kdp1965/ihp-um-janestreet-prism/Calvin.png

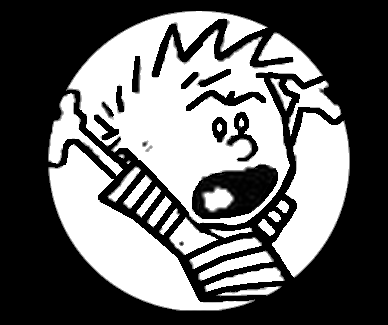
Calvin.png
