kdp1965/ihp-um-janestreet-prism/docs/user_peripherals/08_comm_register.png

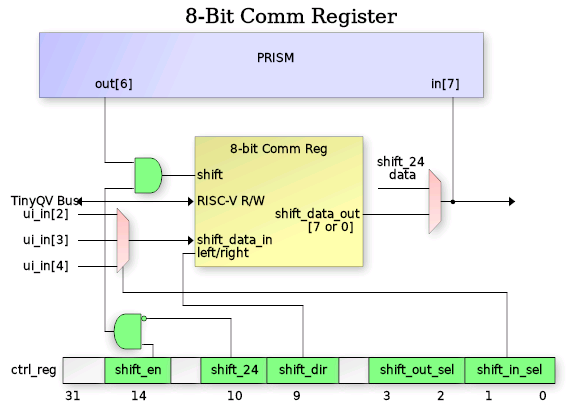
docs/user_peripherals/08_comm_register.png
