kdp1965/ihp-um-janestreet-prism/macros/CALVIN_UP/preview.png

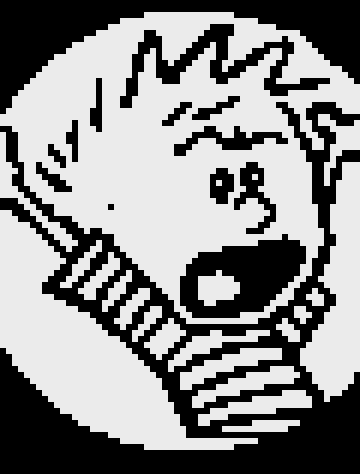
macros/CALVIN_UP/preview.png
