kdp1965/ihp-um-janestreet-prism/site/JaneStreet_PRISM_PDN.png

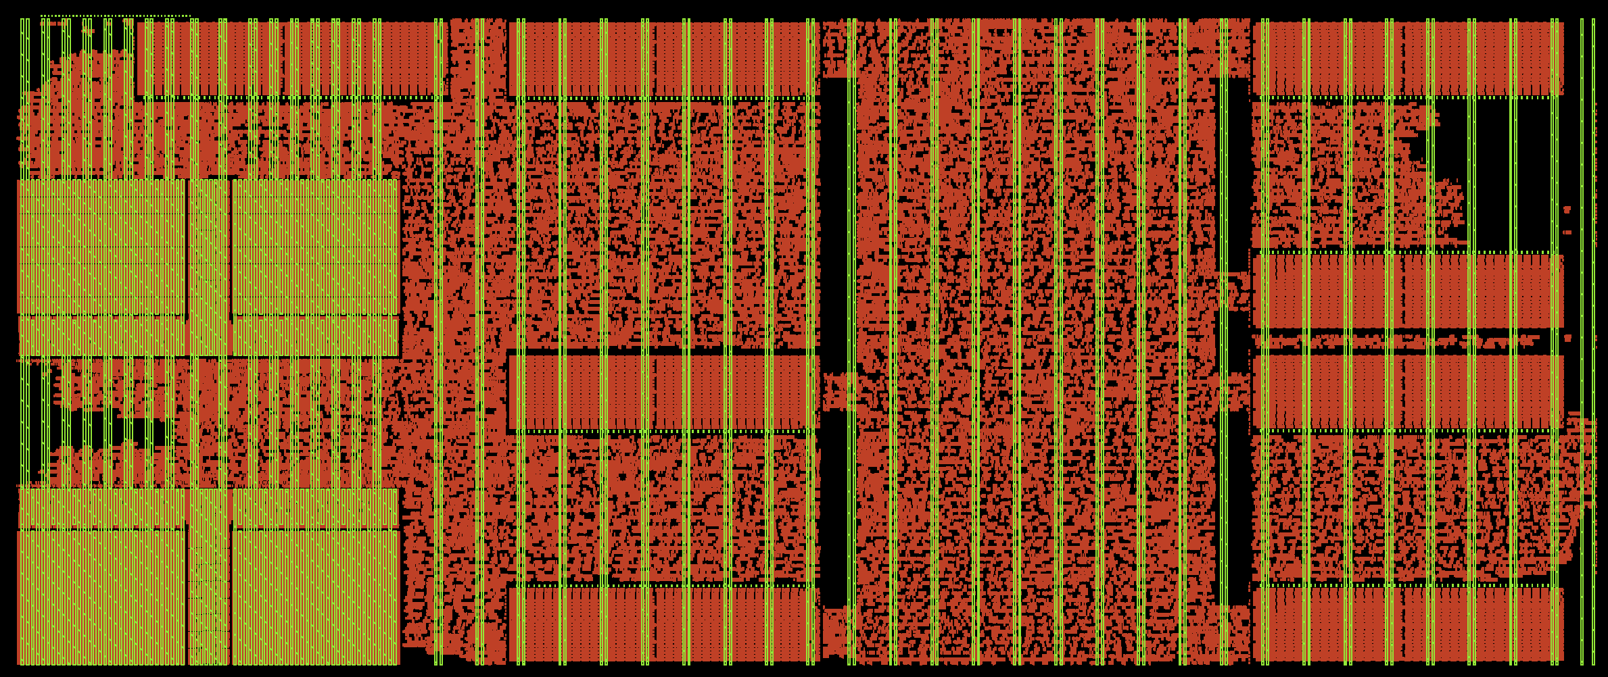
site/JaneStreet_PRISM_PDN.png
