kdp1965/ihp-um-janestreet-prism/local_build/metrics.csv

Metric | Value
design__lint_error__count | 0
design__lint_timing_construct__count | 0
design__lint_warning__count | 37
design__inferred_latch__count | 0
design__instance__count | 72371
design__instance__area | 1184660
design__instance_unmapped__count | 0
synthesis__check_error__count | 0
design__max_slew_violation__count__corner:nom_fast_1p32V_m40C | 644
design__max_fanout_violation__count__corner:nom_fast_1p32V_m40C | 520
design__max_cap_violation__count__corner:nom_fast_1p32V_m40C | 45
power__internal__total | 0.011855394579470158
power__switching__total | 0.0037356307730078697
power__leakage__total | 2.741479329415597e-05
power__total | 0.015618439763784409
clock__skew__worst_hold__corner:nom_fast_1p32V_m40C | -0.438640053361761
clock__skew__worst_setup__corner:nom_fast_1p32V_m40C | 0.4999133470904773
timing__hold__ws__corner:nom_fast_1p32V_m40C | 0.0594799781818965
timing__setup__ws__corner:nom_fast_1p32V_m40C | 1.0040129012360002
timing__hold__tns__corner:nom_fast_1p32V_m40C | 0
timing__setup__tns__corner:nom_fast_1p32V_m40C | 0
timing__hold__wns__corner:nom_fast_1p32V_m40C | 0
timing__setup__wns__corner:nom_fast_1p32V_m40C | 0
timing__hold_vio__count__corner:nom_fast_1p32V_m40C | 0
timing__hold_r2r__ws__corner:nom_fast_1p32V_m40C | 0.05948
timing__hold_r2r_vio__count__corner:nom_fast_1p32V_m40C | 0
timing__setup_vio__count__corner:nom_fast_1p32V_m40C | 0
timing__setup_r2r__ws__corner:nom_fast_1p32V_m40C | 1.84766
timing__setup_r2r_vio__count__corner:nom_fast_1p32V_m40C | 0
design__max_slew_violation__count__corner:nom_slow_1p08V_125C | 6237
design__max_fanout_violation__count__corner:nom_slow_1p08V_125C | 520
design__max_cap_violation__count__corner:nom_slow_1p08V_125C | 44
clock__skew__worst_hold__corner:nom_slow_1p08V_125C | -0.5062046480820508
clock__skew__worst_setup__corner:nom_slow_1p08V_125C | 0.609072476360298
timing__hold__ws__corner:nom_slow_1p08V_125C | 0.49745409199907764
timing__setup__ws__corner:nom_slow_1p08V_125C | -7.69049112826307
timing__hold__tns__corner:nom_slow_1p08V_125C | 0
timing__setup__tns__corner:nom_slow_1p08V_125C | -3421.3570474017506
timing__hold__wns__corner:nom_slow_1p08V_125C | 0
timing__setup__wns__corner:nom_slow_1p08V_125C | -7.69049112826307
timing__hold_vio__count__corner:nom_slow_1p08V_125C | 0
timing__hold_r2r__ws__corner:nom_slow_1p08V_125C | 0.497454
timing__hold_r2r_vio__count__corner:nom_slow_1p08V_125C | 0
timing__setup_vio__count__corner:nom_slow_1p08V_125C | 867
timing__setup_r2r__ws__corner:nom_slow_1p08V_125C | -7.690491
timing__setup_r2r_vio__count__corner:nom_slow_1p08V_125C | 862
design__max_slew_violation__count__corner:nom_typ_1p20V_25C | 2100
design__max_fanout_violation__count__corner:nom_typ_1p20V_25C | 520
design__max_cap_violation__count__corner:nom_typ_1p20V_25C | 45
clock__skew__worst_hold__corner:nom_typ_1p20V_25C | -0.46138624782243626
clock__skew__worst_setup__corner:nom_typ_1p20V_25C | 0.5416784951681427
timing__hold__ws__corner:nom_typ_1p20V_25C | 0.2227272873620312
timing__setup__ws__corner:nom_typ_1p20V_25C | 0.36041126658798145
timing__hold__tns__corner:nom_typ_1p20V_25C | 0
timing__setup__tns__corner:nom_typ_1p20V_25C | 0
timing__hold__wns__corner:nom_typ_1p20V_25C | 0
timing__setup__wns__corner:nom_typ_1p20V_25C | 0
timing__hold_vio__count__corner:nom_typ_1p20V_25C | 0
timing__hold_r2r__ws__corner:nom_typ_1p20V_25C | 0.222727
timing__hold_r2r_vio__count__corner:nom_typ_1p20V_25C | 0
timing__setup_vio__count__corner:nom_typ_1p20V_25C | 0
timing__setup_r2r__ws__corner:nom_typ_1p20V_25C | 0.360411
timing__setup_r2r_vio__count__corner:nom_typ_1p20V_25C | 0
design__max_slew_violation__count | 6237
design__max_fanout_violation__count | 520
design__max_cap_violation__count | 45
clock__skew__worst_hold | -0.438640053361761
clock__skew__worst_setup | 0.4999133470904773
timing__hold__ws | 0.0594799781818965
timing__setup__ws | -7.69049112826307
timing__hold__tns | 0
timing__setup__tns | -3421.3570474017506
timing__hold__wns | 0
timing__setup__wns | -7.69049112826307
timing__hold_vio__count | 0
timing__hold_r2r__ws | 0.05948
timing__hold_r2r_vio__count | 0
timing__setup_vio__count | 867
timing__setup_r2r__ws | -7.690491
timing__setup_r2r_vio__count | 862
design__die__bbox | 0.0 0.0 1724.16 710.64
design__core__bbox | 2.88 3.78 1721.28 706.86
design__io | 45
design__die__area | 1225260
design__core__area | 1208170
design__instance__count__stdcell | 31305
design__instance__area__stdcell | 448407
design__instance__count__macros | 10
design__instance__area__macros | 396139
design__instance__count__padcells | 0
design__instance__area__padcells | 0
design__instance__count__cover | 0
design__instance__area__cover | 0
design__instance__utilization | 0.699028
design__instance__utilization__stdcell | 0.552203
design__rows | 395
design__rows:CoreSite | 395
design__sites | 434589
design__sites:CoreSite | 434589
design__instance__count__class:macro | 10
design__instance__area__class:macro | 396139
design__instance__count__class:buffer | 42
design__instance__area__class:buffer | 304.819
design__instance__count__class:inverter | 956
design__instance__area__class:inverter | 5363.37
design__instance__count__class:sequential_cell | 3537
design__instance__area__class:sequential_cell | 154498
design__instance__count__class:multi_input_combinational_cell | 19081
design__instance__area__class:multi_input_combinational_cell | 195518
flow__warnings__count | 1
flow__errors__count | 0
flow__warnings__count:ODB-0220 | 3
flow__warnings__count:STA-1140 | 3
flow__warnings__type_count | 1
flow__warnings__count:ORD-0039 | 1
flow__warnings__count:PSM-0038 | 1001
flow__warnings__count:PSM-0039 | 20
design__power_grid_violation__count__net:VGND | 389512
design__power_grid_violation__count__net:VPWR | 394286
design__power_grid_violation__count | 783798
flow__warnings__count:GRT-0281 | 2
timing__drv__floating__nets | 0
timing__drv__floating__pins | 0
design__instance__displacement__total | 6824.7
design__instance__displacement__mean | 0.218
design__instance__displacement__max | 60.48
route__wirelength__estimated | 1960800
design__violations | 0
design__instance__count__class:timing_repair_buffer | 6808
design__instance__area__class:timing_repair_buffer | 82524.4
design__instance__count__class:clock_buffer | 284
design__instance__area__class:clock_buffer | 6649.78
design__instance__count__class:clock_inverter | 109
design__instance__area__class:clock_inverter | 968.89
design__instance__count__setup_buffer | 201
design__instance__count__hold_buffer | 0
flow__warnings__count:RSZ-0062 | 1
design__instance__count__class:antenna_cell | 530
design__instance__area__class:antenna_cell | 2884.9
global_route__vias | 135
global_route__wirelength | 3910600
flow__warnings__count:GRT-0115 | 2
flow__warnings__count:GRT-0273 | 15
antenna__violating__nets | 0
antenna__violating__pins | 0
route__antenna_violation__count | 0
antenna_diodes_count | 52
flow__warnings__count:EST-0026 | 1001
route__net | 30971
route__net__special | 2
route__drc_errors__iter:0 | 461
route__wirelength__iter:0 | 2585678
route__drc_errors__iter:1 | 199
route__wirelength__iter:1 | 2585577
route__drc_errors__iter:2 | 152
route__wirelength__iter:2 | 2585538
route__drc_errors__iter:3 | 61
route__wirelength__iter:3 | 2585558
route__drc_errors__iter:4 | 5
route__wirelength__iter:4 | 2585567
route__drc_errors__iter:5 | 0
route__wirelength__iter:5 | 2585567
route__drc_errors__iter:6 | 82
route__wirelength__iter:6 | 2583481
route__drc_errors__iter:7 | 79
route__wirelength__iter:7 | 2583433
route__drc_errors__iter:8 | 72
route__wirelength__iter:8 | 2583430
route__drc_errors__iter:9 | 72
route__wirelength__iter:9 | 2583430
route__drc_errors__iter:10 | 32
route__wirelength__iter:10 | 2583499
route__drc_errors__iter:11 | 29
route__wirelength__iter:11 | 2583499
route__drc_errors__iter:12 | 29
route__wirelength__iter:12 | 2583499
route__drc_errors__iter:13 | 4
route__wirelength__iter:13 | 2583547
route__drc_errors__iter:14 | 4
route__wirelength__iter:14 | 2583547
route__drc_errors__iter:15 | 4
route__wirelength__iter:15 | 2583547
route__drc_errors__iter:16 | 3
route__wirelength__iter:16 | 2583548
route__drc_errors__iter:17 | 3
route__wirelength__iter:17 | 2583548
route__drc_errors__iter:18 | 3
route__wirelength__iter:18 | 2583548
route__drc_errors__iter:19 | 0
route__wirelength__iter:19 | 2583550
route__drc_errors__iter:20 | 28
route__wirelength__iter:20 | 2587248
route__drc_errors__iter:21 | 10
route__wirelength__iter:21 | 2587279
route__drc_errors__iter:22 | 9
route__wirelength__iter:22 | 2587278
route__drc_errors__iter:23 | 7
route__wirelength__iter:23 | 2587277
route__drc_errors__iter:24 | 7
route__wirelength__iter:24 | 2587277
route__drc_errors__iter:25 | 7
route__wirelength__iter:25 | 2587277
route__drc_errors__iter:26 | 7
route__wirelength__iter:26 | 2587277
route__drc_errors__iter:27 | 5
route__wirelength__iter:27 | 2587276
route__drc_errors__iter:28 | 5
route__wirelength__iter:28 | 2587275
route__drc_errors__iter:29 | 5
route__wirelength__iter:29 | 2587277
route__drc_errors__iter:30 | 5
route__wirelength__iter:30 | 2587278
route__drc_errors__iter:31 | 5
route__wirelength__iter:31 | 2587279
route__drc_errors__iter:32 | 4
route__wirelength__iter:32 | 2587287
route__drc_errors__iter:33 | 4
route__wirelength__iter:33 | 2587287
route__drc_errors__iter:34 | 4
route__wirelength__iter:34 | 2587288
route__drc_errors__iter:35 | 4
route__wirelength__iter:35 | 2587286
route__drc_errors__iter:37 | 4
route__wirelength__iter:37 | 2587286
route__drc_errors__iter:38 | 4
route__wirelength__iter:38 | 2587287
route__drc_errors__iter:39 | 4
route__wirelength__iter:39 | 2587287
route__drc_errors__iter:40 | 4
route__wirelength__iter:40 | 2587287
route__drc_errors__iter:41 | 4
route__wirelength__iter:41 | 2587287
route__drc_errors__iter:42 | 4
route__wirelength__iter:42 | 2587287
route__drc_errors__iter:43 | 3
route__wirelength__iter:43 | 2587393
route__drc_errors__iter:44 | 3
route__wirelength__iter:44 | 2587393
route__drc_errors__iter:45 | 3
route__wirelength__iter:45 | 2587382
route__drc_errors__iter:46 | 3
route__wirelength__iter:46 | 2587379
route__drc_errors__iter:49 | 3
route__wirelength__iter:49 | 2587379
route__drc_errors__iter:50 | 3
route__wirelength__iter:50 | 2587379
route__drc_errors__iter:51 | 3
route__wirelength__iter:51 | 2587379
route__drc_errors__iter:52 | 3
route__wirelength__iter:52 | 2587379
route__drc_errors__iter:53 | 2
route__wirelength__iter:53 | 2587497
route__drc_errors__iter:54 | 2
route__wirelength__iter:54 | 2587497
route__drc_errors__iter:55 | 2
route__wirelength__iter:55 | 2587515
route__drc_errors__iter:57 | 2
route__wirelength__iter:57 | 2587515
route__drc_errors__iter:58 | 2
route__wirelength__iter:58 | 2587515
route__drc_errors__iter:59 | 2
route__wirelength__iter:59 | 2587515
route__drc_errors__iter:60 | 0
route__wirelength__iter:60 | 2587598
route__drc_errors | 0
route__wirelength | 2585567
route__vias | 292989
route__vias__singlecut | 292989
route__vias__multicut | 0
flow__warnings__count:DRT-0349 | 7
design__disconnected_pin__count | 5
design__critical_disconnected_pin__count | 0
route__wirelength__max | 3079.05
design__instance__count__class:fill_cell | 41056
design__instance__area__class:fill_cell | 340111
timing__unannotated_net__count__corner:nom_fast_1p32V_m40C | 163
timing__unannotated_net_filtered__count__corner:nom_fast_1p32V_m40C | 0
timing__unannotated_net__count__corner:nom_slow_1p08V_125C | 163
timing__unannotated_net_filtered__count__corner:nom_slow_1p08V_125C | 0
timing__unannotated_net__count__corner:nom_typ_1p20V_25C | 163
timing__unannotated_net_filtered__count__corner:nom_typ_1p20V_25C | 0
timing__unannotated_net__count | 163
timing__unannotated_net_filtered__count | 0
design_powergrid__voltage__worst__net:VPWR__corner:nom_slow_1p08V_125C | 1.19956
design_powergrid__drop__average__net:VPWR__corner:nom_slow_1p08V_125C | 1.19995
design_powergrid__drop__worst__net:VPWR__corner:nom_slow_1p08V_125C | 0.000437035
design_powergrid__voltage__worst__net:VGND__corner:nom_slow_1p08V_125C | 0.000285402
design_powergrid__drop__average__net:VGND__corner:nom_slow_1p08V_125C | 4.48055e-05
design_powergrid__drop__worst__net:VGND__corner:nom_slow_1p08V_125C | 0.000285402
flow__warnings__count:STA-1648 | 292
flow__warnings__count:STA-1650 | 1001
design_powergrid__voltage__worst | 0.000285402
design_powergrid__voltage__worst__net:VPWR | 1.19956
design_powergrid__drop__worst | 0.000437035
design_powergrid__drop__worst__net:VPWR | 0.000437035
design_powergrid__voltage__worst__net:VGND | 0.000285402
design_powergrid__drop__worst__net:VGND | 0.000285402
ir__voltage__worst | 1.2
ir__drop__avg | 4.67e-05
ir__drop__worst | 0.000437
klayout__drc_error__count | 0
magic__illegal_overlap__count | 96
design__lvs_device_difference__count | 0
design__lvs_net_difference__count | 0
design__lvs_property_fail__count | 0
design__lvs_error__count | 0
design__lvs_unmatched_device__count | 0
design__lvs_unmatched_net__count | 0
design__lvs_unmatched_pin__count | 0
