kdp1965/ihp-um-janestreet-prism/local_build/render/tt_um_pettit_js_prism.png

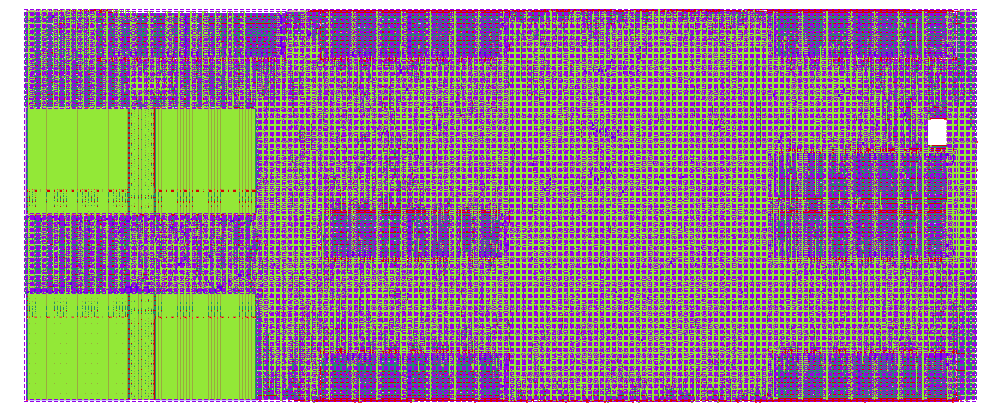
local_build/render/tt_um_pettit_js_prism.png
