kdp1965/ihp-um-janestreet-prism/chromas/output/chroma_encoder.c

/*
==============================================================
PRISM Downloadable Configuration

Input:    chroma_encoder.sv
Config:   tinyqv32.cfg
==============================================================
*/

#include <stdint.h>

const uint32_t chroma_encoder[] =
{
   0x00000000, 0x00000000, 0x14000000, 0x7ffff83e, 
   0x00000000, 0x00000000, 0x14000000, 0x7ffff83e, 
   0x00000000, 0x00000000, 0x14000000, 0x7ffff83e, 
   0x00000000, 0x00000000, 0x14000000, 0x7ffff83e, 
   0x00000000, 0x00000000, 0x14000000, 0x7ffff83e, 
   0x00000000, 0x00000000, 0x14000000, 0x7ffff83e, 
   0x00000000, 0x00000000, 0x14000000, 0x7ffff83e, 
   0x00000000, 0x00000000, 0x14000000, 0x7ffff83e, 
   0x00000000, 0x00000000, 0x14000000, 0x7ffff83e, 
   0x00000000, 0x00000000, 0x14000000, 0x7ffff83e, 
   0x00000000, 0x00000000, 0x14000000, 0x7ffff83e, 
   0x00000000, 0x00000000, 0x14000000, 0x7ffff83e, 
   0x00000000, 0x00000000, 0x14000000, 0x7ffff83e, 
   0x00000000, 0x00000000, 0x14000000, 0x7ffff83e, 
   0x00000000, 0x00000000, 0x14000000, 0x7ffff83e, 
   0x00000000, 0x00000000, 0x14000000, 0x7ffff83e, 
   0x00000000, 0x00000000, 0x14000000, 0x7ffff83e, 
   0x00000000, 0x00000000, 0x14000000, 0x7ffff83e, 
   0x00000000, 0x00000000, 0x14000000, 0x7ffff83e, 
   0x00000000, 0x00000000, 0x14000000, 0x7ffff83e, 
   0x00000000, 0x00000000, 0x14000000, 0x7ffff83e, 
   0x00000000, 0x00000000, 0x14000000, 0x7ffff83e, 
   0x00000000, 0x00000000, 0x14000000, 0x7ffff83e, 
   0x00000000, 0x00000000, 0x14000000, 0x7ffff83e, 
   0x00000000, 0x00000000, 0x14000000, 0x7ffff83e, 
   0x00000000, 0x00000000, 0x14000000, 0x7ffff83e, 
   0x00000000, 0x00000000, 0x14000000, 0x7ffff83e, 
   0x00000800, 0x00000000, 0x1401fe00, 0x7ffff83e, 
   0x00004000, 0x00000000, 0x14013200, 0x7ffff803, 
   0x00000014, 0x00000000, 0x3400cc00, 0x7ffff818, 
   0x00000014, 0x00000000, 0x14015430, 0x7ffff815, 
   0x00000020, 0x00000000, 0x3400cc10, 0x7ffff818, 

};
const uint32_t chroma_encoder_count   = 128;
const uint32_t chroma_encoder_width   = 128;
const uint32_t chroma_encoder_ctrlReg = 0x00002000;
const uint32_t chroma_encoder_pinmuxReg = 0x001FFFFF;
