kdp1965/ihp-um-janestreet-prism/chromas/chroma_onewire.v

// =======================================================
// PRISM 1-Wire master Chroma
//
// A Dallas / Maxim 1-Wire controller through one external open-drain
// buffer: cond_out[0] = 1 pulls DQ low, the line level comes back on
// ui_in[0] (the shifter input).  Standard-speed timing from two timers:
//
//   count1  = one unit u (PRELOAD + 1 clocks; 5.5 us = PRELOAD 351 at
//             64 MHz), counted in count2 against COMPARE = 12 (66 us):
//             write-0 low, the slot length and the presence sample
//   timer 2 = the reset pulse: PRELOAD2 = 480 us with restart on entry
//             into RESET_LOW (T2_RELOAD | T2_STATE(1), free-running), so
//             its first tick ends the low and its second, 480 us after
//             the release, ends the presence window
//
//   slot   write 1: low 1u, released to 12u        (6 us / 66 us)
//          write 0: low 12u, released 1u           (66 us + 6 us recovery)
//          read:    low 1u, released, DQ sampled at 2u (11 us), to 12u
//   reset  low 480 us, released; DQ sampled at 66 us: low = presence,
//          latched into FLAGS[7] (latched_in[1]); interrupt at 960 us
//
// Bits go LSB first.  Host side (shard 0 unfractured, both FIFOs):
//   - host_in[0] = 1 starts a session: reset + presence, then bytes from
//     FIFO B (shard 1's window, TX) are written as they arrive; while
//     host_in[1] = 1 and FIFO B is empty, bytes are read into FIFO A
//     (own, RX) until host_in[1] drops - the host reads FIFO A's count
//     and stops after the bytes it wants; host_in[0] = 0 ends the session
//   - CONST K0 = 0 (the read shift register's seed)
//   - PRELOAD, COMPARE = 12, PRELOAD2 as above
//
//   PRISM_SIGNAL    TT Pin        Function
//   ============    ===========   ======================
//   cond_out[0]     uo_out[1]     DQ pull-low (1 = drive DQ low)
//   prism_in[0]     ui_in[0]      DQ level
// =======================================================
module chroma_onewire
(
   input  wire          clk,
   input  wire          rst_n,
   input  wire          fsm_enable,
   input  wire [31:0]   in_data,       // Inputs to the PRISM
   output wire [20:0]   out_data,      // FSM outputs
   output reg  [1:0]    cond_out,      // Conditional outputs
   output reg  [31:0]   ctrl_reg,      // CFG0 for this chroma
   output reg  [20:0]   pinmux_reg     // uo_out[7:1] source selects (see prism_periph.v)
);
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
