kdp1965/ihp-um-janestreet-prism/(commit log)

2026-09-13 PRISM + TinyQV for the Jane Street CMOS5L 8x4 tile: initial import
    Starting point is ttsky26a-qv-prism (PRISM peripheral on the TinyQV
    RISC-V SoC) ported to IHP SG13CMOS5L through the Tiny Tapeout cmos5l
    template, then reworked per changes.md (phases 0-2 of the plan).
    Infrastructure
    - RTL guarded for sg13cmos5l cells; CFGMEM_IHP16 / CFGMEM_IHP_LEFT16
    DFFRAM-built latch macros (route-through LEF) hold the state table
    - 8x4 tile template in tt_8x4/ (no cmos5l 8x4 exists upstream yet),
    flow.py + odb_stripes.py extend the single-layer PDN stripes over the
    macro power pins, `make harden` runs it locally
    - TinyQV peripheral map: PRISM is peripheral 8 and owns 0x8000200-0x3FF
    fully decoded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
    [tinyqv.cfg, tinyqv16.cfg, tinyqv32.cfg, tinyqv32_shard.cfg, tinyqv_lut3.cfg]
2026-09-13 PRISM: FIFO and CRC per shard, UART TX chroma (Phase 4, changes.md items 8, 9)
    prism_fifo.v: 16 x 8-bit standard-cell FIFO per shard. CFG0[23] fifo_dir
    picks RX (the FSM pushes comm with OUT_FIFO_WR_RD, the host pops by
    reading +0x20) or TX (the host pushes by writing +0x20, OUT_FIFO_WR_RD
    pops the head into comm). +0x24 reads {count, almost_full, almost_empty,
    full, empty} and any write flushes; CFG1[19:16]/[23:20] set the almost
    levels. Push on full / pop on empty are ignored; contents survive PRISM
    disable so a TX FIFO can be filled before the FSM starts. Inputs 20/21
    empty/full, 26/27 almost full/empty.
    prism_crc.v: 32-bit bit-serial LFSR per shard with programmable
    polynomial (+0x2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
2026-09-13 test: sdk_check program drives the PRISM through the tinyQV-sdk driver (Phase 5)
    test/programs/sdk_check builds against tinyQV-sdk with
    PRISM_CONFIG=PRISM_CONFIG_JANESTREET (prism_js.o linked ahead of
    tinyQV-sim.a) and exercises the driver on the RTL: prism_load_chroma_ex
    with the UART TX chroma, TX FIFO push, CRC8, the CRC trailer interrupt,
    a conditional breakpoint with step and resume, prism_load_shards with
    per-shard registers and interrupt, and prism_test_config. The cocotb
    side (test_sdk_check.py) decodes the UART on uo_out[1] and checks the
    message plus its CRC. `make sdk_check` in test/.
    Claude-Session: https://claude.ai/cod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
2026-09-13 Floorplan, CI-safe power stripes and timing closure (Phase 6, changes.md item 1)
    Floorplan: the CFGMEM macros' 70 data pins are on their south edge, so the
    four macros per column are now rows 0 and 96 flipped (FS, pins up) and
    rows 67 and 163 upright (pins down): each pair faces one of two 44-row
    standard-cell areas and the middle two stand back to back across a 6-row
    channel. The left column moves from x = 801.44 to 751.44 um to widen the
    vertical channel between the columns. Global-route overflow dropped from
    6613 to 2296 cells and detailed routing converges in 12 iterations
    instead of 41; wirelength 2.03 m (was 2.16).
    Power stripes without a custom flow: odb_stripes.py is now a LibreLa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
    [flow.py, librelane_plugin_prism_pdn.py, odb_stripes.py, project.v]
2026-09-13 2x2-per-bank floorplan (plan of record), per-bank CFGMEM chains, tracking SI
    Floorplan: the eight CFGMEM macros sit along the top of the tile as one
    2x2 block per bank (bank A at x = 101.44 / 451.44 um, bank B at 951.44 /
    1301.44 um; top row N at y = 619.92, second row FS at y = 510.30), leaving
    the lower ~60% of the tile free for future macros. Hardened clean (Magic
    DRC 0, LVS 0, routing violations 0, antenna 0); typ setup +0.91 ns, PRISM
    path +1.07 typ / -6.41 slow. The two-column and stacked experiments are
    documented in docs/prism_interface.md 4d for comparison.
    CFGMEM: the programming chains now run within a bank (host -> lo0 -> lo1
    -> lo2 -> lo3 and host -> hi0 -> hi1 -> hi2 -> hi3)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
2026-09-13 PRISM: shard 0 owns both FIFOs unfractured, FIFO flag input slots, in_prev edge capture
    Two FIFOs: unfractured, shard 1's FIFO (B) belongs to shard 0. Output 15
    (OUT_SEMA_CLEAR, idle unfractured) becomes OUT_FIFO_PUSH_POP: bit 5
    strobes the own FIFO A when it is 0 and FIFO B when it is 1, each per its
    own direction, so with A = RX and B = TX it reads as push / pop and a
    single-FIFO chroma behaves as before. The host still configures and
    serves B through the shard 1 window. chroma_fifo_loop moves bytes from
    B to A and counts them.
    FIFO flag slots: inputs 20 / 21 (own FIFO) and 26 / 27 (FIFO B, shard 0
    unfractured) each show one of empty / full / almost-empty / almost-full,
    selected in CFG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
2026-09-13 USB low-speed device chroma and the core features it needed (stretch-goal evaluation)
    chroma_usb_ls: a 1.5 Mbit/s USB device on ui_in[4:5] / uo_out[2:4] (D+,
    D-, output enable for external tri-state buffers). Receives SETUP / OUT
    tokens and DATA packets (NRZI decode, un-stuffing, CRC16 residual check,
    payload and CRC into FIFO A), answers ACK, answers IN from the response
    queued in FIFO B or with NAK. 32 of 32 states. The cocotb host model
    (usb_model.py) sends tokens, data and handshakes with CRC5 / CRC16, bit
    stuffing and NRZI, decodes the device's replies and mirrors its drive
    back to the inputs while it transmits. PRISM_ONLY=usb runs just this
    test; findings in docs/prism_interface.md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
2026-09-13 test: split the PRISM unit test into a bench, device models and one class per subject
    test/user_peripherals/prism/test.py was one 1150-line coroutine with
    nested helpers and models gated by a shared name. It is now:
    - regs.py: register map, CFGMEM constants, debugger helpers, CRC models
    - bench.py: PrismBench (reset, clock, bus, CFGMEM and chroma loading,
    enable / IRQ / debugger status, tracer) and the PrismTest base class
    - models.py: 74165 / 74595 shift registers, SPI master, UART receiver
    and WS2812 slave as start/stop classes (the USB host got the same)
    - prism_tests.py: RegisterTest, StewIntegrityTest, EncoderTest,
    Ws2812Test, Gpio24Test, SpiSlaveTest, UartTxTest, FifoLoopTest,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
    [bench.py, models.py, prism_tests.py, regs.py, test.py, usb_model.py]
2026-09-14 SRAM FIFO in the tile: word-assembly wrapper, 44.96 um PDN grid, column floorplan signed off
    Physical:
    - CFGMEM_IHP16 / CFGMEM_IHP_LEFT16 regenerated on the IHP SRAM's power-column
    grid (PDN pitch 44.96 = 4 x 11.24 um, VGND 5.62 um from VPWR) so full-height
    tile stripes power both the macros and the SRAM; tile config uses the same
    pitch/spacing with VOFFSET 6.15.
    - Plan of record: two full-height CFGMEM columns at x 537.11 / 1346.39 on that
    grid, 1024x32 SRAM flush left at the bottom (FS), 2 um macro halo. Official
    harden: GRT 1734, DRT 0 in 5 iterations, KLayout DRC 0, LVS clean, typ setup
    +0.59 ns. The band-layout alternative (v6: SRAM bottom right under the 2x2
    band, DRC/L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
2026-09-14 Two 512x32 SRAM FIFOs, one per shard (Ethernet RX + TX buffers), signed off
    - tqvp_prism: SRAM_FIFO is now the number of SRAM FIFOs (0 / 1 shared / 2 one
    per shard, shard s <-> SRAM s; unfractured shard 0 still reaches SRAM 1 as
    FIFO B); SRAM_AW 9 selects RM_IHPSG13_1P_512x32 (2 KB). Instances are
    SRAM[n].M512.i_sram (separate generate ifs: an else-if chain gave yosys a
    genblk1 in the path). Black box + simulation model + define defaults.
    - Floorplan: the two macros stacked flush left with their pin faces toward
    each other, (3.36, 3.78) FS and (3.36, 294.84) N, both wrappers in the
    100 um gap; the same power columns, so one set of stripes serves both.
    - odb_stripes.py: delete o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
2026-09-14 Ethernet receive: Manchester bit recoverer, eth_rx chroma, fractured TX->RX loopback; chromas with named CTRL/PINMUX fields
    - prism_mrx.v: per-shard Manchester bit recoverer on the PRISM clock (CFG3 at
    +0x3C: [2:0] input pin, [3] enable, [7:4] clocks per half bit, [8] shifter
    input = the recovered bit). An edge is accepted three quarters of a bit
    after the last accepted one, so every mid-bit edge re-times the decoder;
    the bit is the level after it; "bit valid" (CFG2 slot code 15) holds until
    the FSM's shift consumes it.
    - chroma_eth_rx.v: four states; SFD from the first two consecutive 1s read
    as comm[7:6], one transition per bit (shift + CRC32 + count), a byte push
    every eigh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
2026-09-14 Second timer: free-running PRELOAD2 paces the Ethernet link pulses
    - tqvp_prism: PRELOAD2 (+0x40 per shard), a 24-bit down counter that reloads
    itself and raises input 28 for one clock every PRELOAD2 + 1 clocks (0 =
    off). Input 28's CFG2 default was a constant 0 and is now the tick, so no
    slot code and no output bit were needed.
    - chroma_eth_tx: a link pulse on the tick as well as on the host's toggle
    (nlp_tick | (host1 ^ in_prev1); the compiler rejects || with != inside), so
    PRELOAD2 = 959999 at 60 MHz keeps the link alive with no CPU help; a frame
    in flight ignores ticks.
    - EthernetTxTest: four pulses in four periods, none with the timer off, a
    frame transmitted intact with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
2026-09-14 PDN: full-height power ports for the TT pin check, SRAM stripes per region
    The abstract LEF exports every Metal4 VPWR/VGND box as a PORT rect and the
    Tiny Tapeout pin check rejects a power port rect more than 10 um from the
    bottom or top edge; the final LEF had 94 of 141 failing (pdngen's segments
    between the macros of each CFGMEM column, and its four-piece channel-repair
    VGND stripe beside the IHP16 column, which is the only VGND feed for the 98
    short rows there). odb_stripes.py now ends with a tidy pass: one
    full-height stripe box and one pin box per stripe x, partial-height-only
    stripes extended to full height with rail vias on the rows they newly cross.
    The IHP SRAM's three regions (tw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
    [odb_stripes.py]
2026-09-15 PRISM tracer: per-clock execution capture into the SRAMs, latch FIFOs
    A tracer per shard (TRACE_CFG +0x44, TRACE_CTRL +0x48): from a trigger
    (at once, in a state, that state taking a jump, or an edge on any PRISM
    input) every clock's {executing, tree 1 taken, tree 0 matched, the six
    selected LUT inputs, SI} is recorded as a 16-bit entry, two per SRAM
    word, until the buffer is full: 1024 entries in the shard's SRAM or 2048
    across both. One shard traces at a time (shard 0 wins). The SRAM trace
    port (prism_trace_port.v, next to the macro) packs the entries and hands
    them to the SRAM FIFO wrapper, whose window then serves them to the host
    as bytes; the 21 outputs follow from the entry and the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
2026-09-15 PRISM: timer 2 restart on state entry, trace into the other SRAM
    - PRELOAD2[24] restarts the 24-bit count whenever the shard enters state
    PRELOAD2[29:25] (next SI is it, current SI is not); [30] makes it one-shot.
    A retriggerable timeout with no STEW bits; the core exports next_si per
    shard (trace_nsi / trace_nsi_1) for it.
    - TRACE_CFG[6] "other": the shard traces into the other shard's SRAM, so its
    own SRAM FIFO keeps streaming (Ethernet TX/RX can be traced); the entries
    are read through the other shard's window.
    - Tests: test_timer2 replays timer2/timer2_tick against a model of the
    counter (free-running, restart, one-shot; shard 0 and fractured shard 1);
    TraceTest gains the o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
2026-09-15 PRISM: constant table (the latch FIFO as addressable constants), diode padding
    - CONST_TAB (+0x4C, latches): with [0] the shard's 16x8 latch FIFO rows are
    16 constants at a 4-bit index; OUT_COMM_LOAD loads the row and
    {OUT_K_SEL1, OUT_K_SEL0} says how the index moves on that load: clear,
    + 1, + add_to_idx [10:8], = idx_load [7:4] (+ idx_load with [1]). The row
    loaded is the one after the move ([2] post: before it); while the shard is
    not executing the head is the row at the index, so the host and debugger
    see it. A write also sets the index from [19:16], which reads back live.
    prism_fifo.v gains a table read select on its existing head mux.
    - chromas/chroma_const_tab.v: six l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
2026-09-15 docs: floorplan experiment 4d.2 (macro in the top row); route_heat reads macros from the run
    - Section 4d.2: CFGMEMS_LEFT[1].cfgmem_lo moved to the top row and
    LEFT[0].cfgmem_hi raised 9 rows (run 14): global routing improved
    (wirelength -6%, Metal3 overflow -57%) but detailed routing fell behind
    run 13 and stalled at 93 with persistent Metal4 signal shorts; stopped
    and reverted.
    - tools/route_heat.py takes the macro outlines from the run's
    resolved.json and prints per-layer demand statistics.
    Claude-Session: https://claude.ai/code/session_016ZrnpzjvytBAKszwmB4Yu1
2026-09-16 PRISM: edge-clocked sampler (CFG3[27:16]) and the I2C master chroma
    - Sampler: on the rising / falling / either edge of any PRISM input
    (CFG3[21:17], [23:22]) the shard shifts ([24]), counts count2 ([25]),
    captures the in_prev flops ([26]) or reloads count1 ([27]) with no state
    transition; actions OR into the FSM's outputs and are exec-gated with
    them. A sticky "edge pending" flag (cleared by OUT_SHIFT / OUT_LATCH)
    is slot code 15 alongside the recoverer's bit valid and FLAGS[11].
    Frees the bit loop of clocked slave protocols and samples on the edge
    itself. test_sampler; docs 4p.
    - chromas/chroma_i2c_master.v (25 states): I2C controller through two
    external open-drain buffe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
2026-09-16 PRISM: I2C slave chroma on the sampler; CFG3[28] flag2 swaps the sampler edge
    - chromas/chroma_i2c_slave.v (13 states, no bit loop): the sampler shifts
    SDA in on SCL rising edges and counts them; the 7-bit address is compared
    after the seventh edge so K3 serves reads and writes; R/W is latched into
    flag2, which with the new CFG3[28] makes the sampler shift on SCL falling
    edges for the read direction. FIFO A takes writes, FIFO B serves reads
    (0xFF when empty), interrupt at STOP / end of read. I2cMaster model in
    models.py; test_i2c_slave; docs 4q.
    - Sampler CFG3[28]: flag2 swaps rising and falling (one FSM flag turns a
    bidirectional protocol's sampling edge). Docs 4p.
    - The sl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
    [chroma_i2c_slave.c, chroma_i2c_slave.py, chroma_i2c_slave.v, models.py, prism_periph.v, prism_tests.py, regs.py, test.py]
2026-09-16 PRISM: multi-bit comm shift (PIO style), COMM_PINS lanes, triggered pio chroma
    - CFG0[2]: every OUT_SHIFT moves {OUT_K_SEL1, OUT_K_SEL0} + 1 bits (1-4)
    through comm from inputs shift_in_sel .. + 3 (higher pin = higher bit,
    MSB first below the byte, LSB first at the top); the shift count advances
    by the width and a comm_load_one load counts the width. The sampler's
    shift action is width-aware.
    - COMM_PINS (+0x50, 21-bit latch): the comm bit each uo_out pin with pinmux
    code 6 shows while CFG0[2] is set; code 6 is the serial bit otherwise.
    - chromas/chroma_pio.v (5 states): edge-triggered on ui_in[0] (host_in[0] =
    falling), host_in[1] = mode; 4-channel logic analyser on the sampler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
2026-09-17 Adding local build final results (initial).
    [metrics.csv]
2026-09-17 Portable KLayout DRC deck path; full deck as a local override
    The GitHub action failed at configuration: KLAYOUT_DRC_RUNSET was an
    absolute path on the development Mac. It pointed at the IHP-Open-PDK dev
    branch's vendored ihp-sg13cmos5l deck because Tiny Tapeout's pinned
    snapshot ships a trimmed KLayout deck that executes no rules, while the
    dev copy is the full deck (333 rules on this tile).
    src/config*.json now use pdk_dir::libs.tech/klayout/tech/drc/
    ihp-sg13cmos5l.drc, which resolves on any machine (in the CI: the PDK's
    own deck, as Tiny Tapeout's flow intends). Local sign-off keeps the full
    deck through tools/drc_deck.py, which yields -c KLAYOUT_DRC_RUNSET=<dev
    deck> whenever $PDK_RO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
    [flow.py]
2026-09-17 PRISM RTL: double-edge Manchester sampling, comm window mux, 1-Wire and SPI-master chromas
    - prism_mrx: CFG3[9] samples both clock edges (a negedge flop per shard,
    two-flop synchronisers) so the Manchester recoverer sees half-bit
    transitions at lower clocks; the Ethernet RX test covers both modes.
    - prism_periph: the multi-bit comm shift lanes pick from a 4-bit window
    of the comm pins (base 0..4, COMM_PINS latch widened to 18 bits) so a
    PIO-style shift can use any four adjacent pins.
    - chromas: 1-Wire master (16 states) and SPI master (single or quad
    lane), with their cocotb models and tests; SDK check program covers
    the new configuration bits.
    - prism.v: the fracture configurati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
2026-09-17 Flow: rule-based antenna repair only, diodes on the SRAM pins, routing watch and seed sweep tools
    - config: heuristic diode insertion off (it was a third of all cells
    and crowded the CFGMEM pin corners); rule-based repair alone still
    ends at zero antenna violations. A DRC report every four detailed
    routing passes. Cell padding only for the antenna diodes.
    - plugin: Project.DiodesOnSramPins places a diode on every input pin
    of the IHP SRAM macros before the first global route (their LEF has
    no antenna data, so the checker cannot see them).
    - tools/drt_status.py: per-pass violation counts, layer table, densest
    30 um bins and busiest nets of a running or stopped route; --stop
    en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
2026-09-17 CFGMEM macros: eight Do0 pins on the tile-facing side face, Metal2 and Metal3 route-through
    Rebuilt from DFFRAM.librelane (models/cfgmem_ihp*/pin_order.cfg, cmos5l
    tech.yml LEF_ROUTE_THROUGH_LAYERS [Metal2, Metal3]): the Do0 pins nearest
    the tile-facing side face (plus EN0/A0/BYP on the LEFT variant) moved
    from the bottom face to that face beside WE0/WROW, and the abstract now
    exposes the macro's unused Metal2 tracks (about 80%) as well as Metal3.
    DRC, LVS and antenna clean; the run wokwi_m2d53 hardened with these.
    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
2026-09-17 PDN config without the per-macro grid, so an unpatched pdngen builds the grid
    The GitHub action failed at OpenROAD.GeneratePDN with PDN-0233 "Failed to
    generate full power grid". LibreLane's default pdn_cfg.tcl defines a
    grid for every macro; with this tile's single-layer Metal4 PDN
    (PDN_MULTILAYER 0) those grids get no shapes or vias, which pdngen
    treats as a failure. The development machines ran an OpenROAD patched to
    skip that check, so the flow only ever worked there.
    src/pdn_cfg.tcl is LibreLane's file (identical in 3.0.0rc1 and 3.0.2)
    minus the macro grid, selected by PDN_CFG. The macros get their power
    from Project.ExtendPowerStripes as before: the stripes and rails are
    identical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
2026-09-17 docs: 4z.5, the CI power-grid fix and the GRT layer-budget experiment
    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
2026-09-18 The koA recipe: mouth keep-outs, all CFGMEM data pins on Metal4, six antenna rounds
    Every stalled route of this tile died in the rows just outside a CFGMEM
    column's tile-facing edge, at the height of the gap between the two
    macros of a pair: the placer fills that strip to the target density and
    every net into the macro pin rows then crosses its Metal2 tracks.
    - Project.MouthKeepouts (odb_keepouts.py, after the macro placement): a
    density-capped placement blockage (DEF PARTIAL 0.25) 60 um outward
    from each column edge over each pair gap, derived from the macro
    instances. Hot mouth bins go from 53% cell utilisation to under 3%.
    A four-way sweep on bowser showed reaching inward over t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
    [librelane_plugin_prism_pdn.py, odb_keepouts.py]
2026-09-18 gds action: pin LibreLane 3.0.2 so the runner routes with the same OpenROAD as the local flow
    The action's default 3.0.0rc1 synthesises the same netlist as bowser
    (x86-64 ABC) but carries an older OpenROAD, and on the same placement its
    detailed route had not converged when the job hit the 6-hour limit. The
    3.0.2 image is built from the same nix derivations as the development
    shells, so the runner should replay the route that converged on bowser
    (run koA: clean in one start, docs 4z.7) instead of drawing its own.
    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
2026-09-19 PRISM FIFO: two-clock latch write, reader's count follows it
    The row gate was the synthesised AND of the write strobe and the row
    decode, both of which move together. The strobe now goes through one more
    flop (wst_p1) and drives the `wr` input of the row's latch register, so
    the gate is the kept AND2 of a stable row decode and a registered strobe
    and cannot be glitched open while the bank's data bus moves. The write
    lands on the second clock after the push.
    `count` therefore counts a byte one clock later, on the clock the gate
    opens and the byte reaches the head mux; without that the two chromas
    that pop the instant the FIFO reports non-empty (UART transmit, OneWire)
    read the row one clock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
    [prism_fifo.v]
2026-09-20 Adding new local_build files.
    [metrics.csv]
2026-09-20 gl test: simulate the unpowered netlist, with the SRAM models
    The gate-level job had never run to completion in this repo, and it
    failed three ways at once on the custom_gds submission.
    The SRAM macros are black boxes in the tile netlist, and the gate-level
    branch never listed the behavioural models that the RTL branch uses, so
    both RM_IHPSG13_1P_512x32 instances were unknown modules. The model
    list (and PRISM_SRAM_FIFO, which the tests read to skip what needs a
    FIFO) now lives once at the top and all three branches share it.
    With the models in, the powered netlist failed to elaborate with
    hundreds of "port VDD is not a port of ..." errors, macros included:
    the CMOS5L cell models take no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
    [tb.v, test.py]
2026-09-20 gl test: the same unpowered-netlist fixes for the program suite
    The runner got past the basic suite (8 of 8 on the netlist) and then
    died in the program suite, which needed the three fixes the basic one
    had just been given: the behavioural SRAM models on the gate-level
    source list, the unpowered CFGMEM netlists instead of the powered ones,
    and no USE_POWER_PINS. Its testbench connected the supplies on
    GL_TEST, like the other one, so that now follows USE_POWER_PINS too.
    The SRAM model list and PRISM_SRAM_FIFO move to the top of the file and
    are shared by all three branches, as in test_basic.mk.
    With this the program suite elaborates against local_build/nl and runs
    the RISC-V program on the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
    [tb_qspi.v]
2026-09-21 local_build from koJ (40 um keepout, 57% density, all SRAM columns fed)
    The published views are now the koJ harden, saved on bowser as
    runs/koJ_golden. Against koA: routing DRC, antenna, KLayout DRC and LVS
    all 0 as before; setup worst slack +0.96 ns typical (was +0.15),
    -6.33 ns at the slow corner (was -7.47) with total negative slack there
    down a fifth; hold positive at every corner. 26390 cells, 63.2%
    utilisation. Routing took 57 passes in the first round and seven hours
    in all, against four and a quarter for koH.
    prism_fifo.v is the source koJ was built from: one 8-bit write-data
    register per FIFO feeding both latch banks instead of one per bank, so
    the GDS and the RTL in the tree ag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
    [metrics.csv]
2026-09-22 STEW laid out by consumer: each CFGMEM bank feeds one part of the machine
    The 128-bit STEW used to be laid out by field (mux selects, jump targets,
    then the three 21-bit output vectors end to end, then the LUT tables), so
    every output's three transition legs came from two or three different
    CFGMEM banks and the decision logic drew its LUT tables from the right
    column while its mux selects came from the left: at least 94 STEW wires
    crossed between the columns and each macro mouth fanned out across the
    tile. The new layout keeps the sequencing in the left column and the
    output vectors in the right:
    bank 0 (bits 0- 31): inc, the six input-mux selects, tree1 jump[0]
    bank 1 (bits 32- 63):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
    [tinyqv32.cfg]
2026-09-22 CFGMEM macros with four Metal2/Metal4 route-through channels
    Both CMOS5L CFGMEM macros rebuilt (DFFRAM cfgmem16_cmos5l_ch /
    left_cmos5l_ch) with four 8-site decap columns through the array before
    bits 6, 13, 19 and 26. The placer obstructs Metal2 and Metal4 over them
    above the pin row for the macro's own routing and drops the obstructions
    after detailed routing, so the shape-following abstract exposes 3.84 um of
    continuous vertical tracks at each channel: ladders for the tile's router
    to hop between the Metal3 openings the macro's wiring leaves, instead of
    needing one free track across the full width. The macros are 344.64 um
    wide (were 331.20); the pin row stays open because the evenly sp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
2026-09-23 PRISM: 32-bit FIFO push / pop (FIFO32), ported from the sg13g2 tiles
    FIFO32 (+0x54 in each shard window, CFG3[11]) lets the RISC-V move words
    instead of bytes. TX: a word written there is pushed a byte at a time,
    low byte first, one every fourth clock, waiting on a full FIFO;
    FIFO_STATUS[5] is busy meanwhile and a word written while busy is
    dropped, so poll it when the FIFO can be full (straight-line code never
    sees it: four pushes take 13 clocks against 16 per instruction). RX: a
    pop machine takes four bytes as soon as the FIFO holds them, low byte
    first, into a word register; FIFO_STATUS[4] and the shard's interrupt say
    the word is complete and a read of FIFO32 takes it. A byte read of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
2026-09-23 Drop the placement keep-outs after routing so the filler can use them
    Ported from the sg13g2 tiles (8x4 a81f230). The mouth keep-outs earn
    their place during placement and routing but stayed in the database
    afterwards, and the filler skips blocked area, so the strips shipped as
    bare rows with no decoupling capacitance. Project.DropKeepouts removes
    them right after Checker.TrDRC, before OpenROAD.FillInsertion: detailed
    routing is signed off, so placement and routing are settled, and fill and
    decap cells carry no signal pins, so they cannot take back the Metal2
    tracks the keep-outs protected.
    Claude-Session: https://claude.ai/code/ses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
    [librelane_plugin_prism_pdn.py, odb_keepout_drop.py]
2026-09-23 CFGMEM: a programming chain per macro column, readback muxed at the column
    The placed database showed the two biggest Metal3 consumers through the
    upper-right macro mouth were host programming paths, not the FSM: the
    single chain host -> 0 -> 1 -> 2 -> 3 sent the 32-wire link from bank 1
    (left column) to bank 2 (right column) across the whole middle corridor,
    64 wires per tile for a path that only runs during download, and the host
    readback carried every macro's 32 output bits to the read mux beside the
    CPU, 128 wires the same way. Together 77 mm of horizontal reach, ten
    times all the PRISM registers in that channel.
    Now each column has its own chain (host -> 0 -> 1, host -> 2 -> 3, the
    sa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
2026-09-23 CFGMEM macros with every data pin on Metal4 and no Metal2 at the mouth
    The same channel layouts as before (right: full-width channel after the
    first latch column, half-width before bits 13, 19, 26; left: half-width
    before bits 6, 13, 19, full-width before the decoder), rebuilt with all 32
    Di0 pins on Metal4 beside the 24 Do0 already there (DFFRAM
    cfgmem16_cmos5l_ch7 / left_cmos5l_ch7), and the right macro's EN0, A0
    and BYP moved from the bottom face to its side face next to WE0 and WROW,
    matching the left macro. The mouth corner where every run's last
    violations sat held the right macros' Metal2 control pins and the Metal2
    Di0 escapes; the macros now present no Metal2 pin at all: 56 Metal4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
2026-09-23 CFGMEM macros with Metal2-only route-through channels
    Same pins and channel layout as before (every data pin on Metal4, the
    control pins on the side faces), rebuilt with the channel obstruction on
    Metal2 only (DFFRAM cfgmem16_cmos5l_ch8 / left_cmos5l_ch8). Both ch7
    hardens routed the tile down to the same residue: Metal4 shorts against
    VGND at the left column's first channel where the channel's Metal4 ladder
    met the tile's stripe via pads at three macro edges, and the repair rounds
    doubled them rather than clearing them. Leaving Metal4 to the macro's own
    router removes the collision; the Metal2 ladder is what the tile router
    used anyway. Both 340.32 um, sign-off clean, regression passes.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
2026-09-23 CFGMEM_IHP16: Di0[1] moved off the tile's VGND stripe (ch9)
    The right macro's Metal4 pin Di0[1] sat 0.07 um inside the tile's VGND
    stripe at x 1362.40-1364.50 (the macro had dropped its own rail there
    for the first route-through channel, so the pin placer did not see it):
    four VGND shorts, LVS failures on every ch7/ch8 run. Rebuilt with the
    fixed DFFRAM placer: Di0[1] at 18.52 um, no other pin moves, macro
    DRC/LVS/XOR clean. Left macro unchanged from ch8.
    Tile runs/ch9 (density 57, keep-out 40): route DRC 0, antenna 0,
    KLayout DRC 0, LVS 0; DRT to zero at pass 21; GRT 8732; wirelength
    2.169 M um; setup WS -7.97 slow / +0.24 typ, hold +0.067; 50 min.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
2026-09-23 local_build from ch9 (Metal4 data pins, Metal2 route-through channels, per-column chains)
    The Mac harden runs/ch9 (density 57, 40 um keep-out, keep-outs dropped
    before fill): route DRC 0, antenna 0, KLayout DRC 0, LVS 0; DRT to zero
    at pass 21; GRT overflow 8732; 27648 std cells, util 65.4%; wirelength
    2.169 M um; setup WS -7.97 ns slow / +0.24 ns typ, hold +0.067 ns fast;
    13.5 mW. Published through the custom_gds action for precheck, gate
    level and the viewer.
    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
    [metrics.csv]
2026-09-24 PDN: a stripe on every SRAM supply column, and the stripe step's options in git
    The stripe script and plugin that made the koJ build ("all SRAM columns
    fed") only ever lived in the rsynced bowser tree: --sram-layer,
    --clearance, --stack-pitch, --pin-face-margin and
    --sram-all-columns, with the EXTEND_STRIPES_* variables that drive them.
    Both files are strict supersets of the versions in git and pick the same
    via masters; with the options off they reproduce the ch9 behaviour.
    config.json now turns the all-columns feed on (36 VPWR + 36 VGND
    full-height Metal4 stripes per SRAM instead of 11) and sets the
    pin-face margin to 0, which keeps pdngen's rail stacks beside the CFGMEM
    pin faces as ever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
    [metrics.csv]
2026-09-26 RX DMA into PSRAM B: the RTL of the dma_band run (2026-09-24)
    The state of the dma work as synthesized for runs/dma_band (re-synthesis
    of this tree gives a byte-identical netlist to that run's, md5 2c6013cbe3).
    - prism_dma.v: RX DMA engine next to TinyQV, draining a shard FIFO into
    a ring of 2 KB frame slots in PSRAM B over TinyQV's memory port
    (registers at 0x8000020 / 0x8000024, interrupt 10); chain mode moves
    FIFO A into FIFO B so the DMA sees one 32-byte FIFO.
    - tinyqv.v: second master on the QSPI memory port, granted only between
    CPU memory accesses and never inside a continued transfer.
    - prism_periph.v / peripherals.v / project.v: the byte-serial FIFO tap,
    the A-to-B mover,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
2026-09-26 PDN: SRAM column stripes clear of macro pins; every-other array pairs
    Every SRAM column stripe runs the full core height, so it also crosses
    any macro above or below the SRAM. The column choice checked the tile's
    own pins and other macros' rails but not other macros' signal pins on the
    stripe layer: in runs/dma_band (all columns fed) the stripes crossing
    CFGMEMS_LEFT[1].cfgmem_lo, placed over the SRAMs at the top left, sat on
    or within 0.24 um of 41 of its 56 Metal4 data pins, and 12 of the run's
    final DRC violations were these fixed shorts / spacing errors. Columns
    now keep 0.5 um from every hard macro's signal pin on the stripe layer, in
    every mode.
    New option --sram-array-every-other (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
    [librelane_plugin_prism_pdn.py, odb_stripes.py]
2026-09-26 local_build from dma_band_eo_l1e: the RX DMA tile signs off
    The band layout (CFGMEMS_LEFT[1].cfgmem_lo at the top left by the tile
    pins) with that macro at (132.47, 619.92) N, one 44.96 um grid step east
    of dma_band's 87.51 so its westmost Metal4 pins leave SRAM[1] alone; the
    SRAMs at their ch9 spots; density 57, 40 um keep-out; the every-other
    SRAM array stripes in place of all-columns feeding. src/config.json
    now equals the run's merged config, bar the tile template keys.
    runs/dma_band_eo_l1e (2026-09-26): GRT overflow 8701 (dma_band 8879);
    DRT to zero at pass 47, antenna repair rounds of 48, 5 and 1 diodes,
    each routed back to zero; route DRC 0, antenna 0, KLayout DRC 0, LVS 0
    (nothing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
    [metrics.csv]
2026-09-26 CFGMEMS_LEFT[1].cfgmem_lo as CFGMEM_IHP_LEFT16_SRAM, swapped in after synthesis
    CFGMEM_IHP_LEFT16_SRAM (DFFRAM make left_cmos5l_sram) is the ch8 LEFT16,
    same netlist and pins, rebuilt for CFGMEMS_LEFT[1].cfgmem_lo's spot above
    SRAM[1] (132.47, 619.92 N): its 24 Metal4 rails sit on SRAM[1]'s supply
    columns - every other pair of both bit-cell arrays, the periphery band's
    outer pairs, the grid pair past the SRAM edge - and its pins keep 0.6 um
    from them. The plain LEFT16 there got 4 of its 15 rails fed; now every
    SRAM stripe across the macro is one of its rails.
    Project.SwapMacroCells (librelane_plugin_prism_pdn.py; flow.py and
    meta.substituting_steps "+Yosys.Synthesis") gives the instances l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
    [CFGMEM_IHP_LEFT16_SRAM.nl.v, CFGMEM_IHP_LEFT16_SRAM.pnl.v, flow.py, librelane_plugin_prism_pdn.py, odb_stripes.py]
2026-09-26 local_build from sram16: the new submission candidate
    runs/sram16 = this tree's flow (CFGMEMS_LEFT[1].cfgmem_lo swapped to
    CFGMEM_IHP_LEFT16_SRAM after synthesis, rails on SRAM[1]'s columns; the
    synthesized netlist unchanged from dma_band_eo_l1e), signed off clean:
    route DRC 0, antenna 0, KLayout DRC 0, LVS 0 (nothing unmatched), IR drop
    0.39 mV, no hold violations. GRT overflow 8770, DRT to 0 at pass 52,
    antenna rounds of 57 and 1 diodes each back to 0; setup WS -6.50 ns slow /
    +0.78 typ, hold +0.10 fast; 28855 std cells, util 66.8%; wirelength
    2.21 M um; 14.3 mW; 5 non-critical disconnected pins (as before). Tiny
    Tapeout power-pin rule: 0 of 92 Metal4 power rects failing.
    Co-Authored-By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
    [metrics.csv]
2026-09-26 RTL: CFGMEMS_LEFT[1].cfgmem_lo instantiates CFGMEM_IHP_LEFT16_SRAM
    src/peripherals.v writes the left CFGMEM column out instead of looping
    over it, with the escaped instance names the loop generated
    (\CFGMEMS_LEFT[1].cfgmem_lo ...), so MACROS, the PDN hooks and every other
    config entry still apply, and makes CFGMEMS_LEFT[1].cfgmem_lo the SRAM-aligned
    macro. cfgmem_left_sram.v is its model: a wrapper of the LEFT16 model for
    simulation, a black box for synthesis (EXTRA_VERILOG_MODELS). The
    post-synthesis swap is no longer used (MACRO_CELL_SWAPS unset; the step
    stays in the flow and does nothing); branch dma keeps that variant.
    Synthesis gives the same netlist as the swap route up to yosys's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
    [cfgmem_left_sram.v, peripherals.v]
2026-09-26 local_build from rtl16: the new baseline
    runs/rtl16 = this tree's full flow from synthesis, signed off clean: route
    DRC 0, antenna 0, KLayout DRC 0, LVS 0 (nothing unmatched), IR drop 0.33 mV,
    no hold violations. GPL congestion 1.229 / +3.6 % inflation, GRT overflow
    1537/6619/260 = 8416 (sram16 8770), DRT to 0 at pass 40 (sram16 52),
    antenna rounds of 55 and 8 diodes each back to 0; setup WS -5.78 ns slow /
    +0.92 typ (sram16 -6.50 / +0.78), hold +0.093 fast; 736 slow-corner setup
    violations (810); 28818 std cells, util 66.8%; wirelength 2.202 M um;
    14.3 mW; 5 non-critical disconnected pins. Tiny Tapeout power-pin rule:
    0 of 92 Metal4 power rects failing.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
    [metrics.csv]
2026-09-27 PRISM TX DMA: a PSRAM B slot into FIFO B through the memory port, RX first
    prism_txdma.v, next to TinyQV and the RX DMA in project.v, copies one frame
    (up to 2 KB, a 2 KB-aligned slot of RAM B) into FIFO B, shard 1's SRAM FIFO
    on SRAM[1] (the TX FIFO of the unfractured chromas). TXDMA at 0x8000028:
    write [11:0] length, [23:12] slot, [24] skip the 4-byte slot header (the RX
    DMA's slot format, so a received frame can go straight back out), [25]
    interrupt enable, [30] acknowledge, [31] start; read [11:0] bytes left,
    [30] done, [31] busy. Interrupt 11.
    Reads are bursts of up to 8 words in one QSPI transaction (TinyQV's
    data_continue; tinyqv.v's DMA port gains read strobes and read data),
    neve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
    [main.c, peripherals.v, prism_periph.v, prism_txdma.v, project.v, test_txdma_verify.py, tinyqv.v]
2026-09-27 local_build from txdma_rsz: the TX DMA tile, the next submission candidate
    src/config.json: RUN_POST_GRT_RESIZER_TIMING. With the TX DMA the full
    flow (runs/txdma) routed clean but missed the typical corner by 0.82 ns:
    a weak gate driving a long wire after the FIFO head, on the path from
    shard 1's state through the CFGMEM and the constant-table select to the
    host read data. The post-CTS repair only sees placement estimates; the
    routed wires cost this tile about 6 ns at the slow corner. Keep-out
    widths of 30, 35, 45 and 60 um (with 55 % density) routed worse or no
    better. Timing repair on global-route parasitics fixed it: 148 buffers,
    285 upsizes, +0.3 % area, and its re-placement / re-ro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
    [metrics.csv]
2026-09-27 txdma_verify: the RX DMA on an SRAM FIFO, and both DMAs on their own SRAMs
    Case 6: FIFO A on SRAM[0] in RX mode, B the flop FIFO; the host pushes a
    1500-byte frame into B, the fifo_loop chroma loops it into A and the RX
    DMA drains A into ring slot 0. An SRAM FIFO's almost-full level counts
    free space in 64-byte units, so level 15 starts bursts at 1088 bytes in;
    A settles one burst below that (1080 bytes measured) until the frame end
    drains the rest. Case 7, full duplex: the TX DMA fills B on SRAM[1] with
    a 2044-byte frame while the chroma loops it into A on SRAM[0] and the RX
    DMA drains A into ring slot 1; when the copy finished A held 1080 bytes,
    so the RX DMA had drained ~960 bytes along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
2026-09-27 ethtx_verify: 10BASE-T frames from PSRAM through the TX DMA
    A RISC-V program test of transmitting from PSRAM with no chroma or RTL
    change: the TX DMA copies a frame from a 2 KB slot of RAM B into FIFO B
    (SRAM[1]) and the eth_tx chroma, fractured on shard 1 (bank B), sends it
    on uo_out[1] (TXD) / uo_out[2] (TX_EN); shard 0 idles with its outputs
    masked. Slot layout: 55 55 55 D5 in bytes 0-3 (the chroma sends four
    preamble bytes from K0 and pops the rest and the SFD), the frame from
    byte 4 without its FCS (the chroma appends it), so an RX ring slot, whose
    frame starts at the same offset, goes back out once word 0 is rewritten.
    Cases: a minimum frame; an odd length (the copy ends with a tail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
2026-09-27 ethloop_verify: 10BASE-T loopback from PSRAM to PSRAM
    RAM B slot -> TX DMA -> FIFO B (SRAM[1]) -> eth_tx on shard 1 -> TXD /
    TX_EN -> the bench's wire -> ui_in[3] -> Manchester recoverer + eth_rx on
    shard 0 -> the flop FIFO A -> RX DMA -> RX ring in RAM B. Both chromas
    run fractured (eth_rx in bank A, eth_tx in bank B); the RX DMA ends each
    frame on eth_rx's host interrupt (hw_end) and bursts from 8 bytes, so a
    frame closes long before the next one could start. The wire is a cocotb
    coroutine (TXD while TX_EN, else idle low, onto ui_in_base[3]).
    The program checks every frame's RX DMA interrupt and ring head, its
    length field (frame + FCS), eth_rx's crc_ok (the CRC register holds the
    CRC32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
2026-09-27 PRISM TX ring and RX slot status: queued frames at the inter-frame gap
    TXRING_CFG (0x800002C) / TXRING_STATUS (0x8000034) in prism_txdma.v: a
    ring of 2^K slots of RAM B (K = 1..4, 8-bit base in 2 KB units), head
    written by TinyQV, tail advanced by the engine. Per slot it reads word 0
    (L, capped at 2044), copies L bytes from slot byte 4 into FIFO B, and
    starts the chroma by toggling shard 1's host_in[0] once the inter-frame
    gap counter has run out and 16 words (or all of them) are in. Shard 1's
    host interrupt ends the frame: it goes to the engine instead of the host
    (like the RX DMA's hw_end), tail advances, the frame-sent flag rises
    (interrupt 11 when enabled) and the gap timer starts. TX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
2026-09-27 local_build from txring2_ko60: the TX ring tile, the next submission candidate
    src/config.json: MOUTH_KEEPOUT_WIDTH back to 60 um, the width section
    4z.6 describes. With the TX ring the same netlist placed with ~28 %
    inflation and GRT overflow 17.6 k / 18.0 k at 40 um and 30 um mouth
    keep-outs; at 60 um it placed with 3.6 %. One draw each: any netlist
    change redraws the placement.
    runs/txring2_ko60 = this tree's full flow from synthesis, signed off
    clean: route DRC 0, antenna 0, KLayout DRC 0, LVS 0 (nothing unmatched),
    IR drop 0.42 mV, no hold violations. GPL congestion 1.320 / +3.6 %
    inflation, GRT overflow 14992 (15551 after the post-GRT repair's
    re-route; 63 min, +128 buffers, 267 up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
    [metrics.csv]
2026-09-28 PRISM count3: a per-shard up counter with a limit from the data
    count2 takes its commands on two outputs: OUT_COUNT2_INC alone = + 1,
    OUT_COUNT2_DEC alone = - 1, both = clear (no chroma ever set both), so
    output 11 is free. The sampler's count2 + 1 applies after the decode:
    an FSM decrement in the same clock cancels it instead of becoming a
    clear. CFG0[12] no longer gates the decrement; that enable was a
    leftover of the sky25a PRISM, where the decrement shared an output with
    the uo_out[6] pin.
    count3 (prism_datapath.v, one per shard): 8 bits, counts up only. Its
    command is {pin_out[3] with CFG0[12], output 11}: 01 = + 1, 10 = clear,
    11 = limit <= comm. count3 >= limit is input 29 (slot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
    [chroma_count3.c, chroma_count3.py, chroma_count3.v, chroma_encoder.c, chroma_encoder.py, chroma_encoder.v, chroma_eth_rx.c, chroma_eth_rx.py]
2026-09-28 local_build from count3: the count3 tile, the next submission candidate
    runs/count3 = this tree's full flow from synthesis (src/config.json
    unchanged: 60 um mouth keep-outs, density 57, post-GRT resizer), signed
    off clean: route DRC 0, antenna 0, KLayout DRC 0, LVS 0 (nothing
    unmatched), IR drop 0.36 mV, no hold violations. GPL congestion 1.294
    (the routability loop reverted its inflation: +0.0 %), GRT overflow
    15556, post-GRT repair 53 min (173 buffers, 400 upsizes, +0.5 % area);
    detailed routing to 0 at pass 52 (four Metal2 violations of a clock net
    held for ~15 passes at x 1256 y 283, where cells pushed out of the right
    column's keep-out pile up, the same spot txdma_rsz had one), antenna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
    [metrics.csv]
2026-09-28 PRISM CAN 2.0A node: receiver and transmitter chromas on a bit clock, a bit-stuff unit and masked / constant limit loads
    Datapath additions (all off by default, docs 4b.1 / 4b.2):
    - COUNT3 byte 2 = a mask; the limit command with OUT_K_SEL0 loads
    comm & ~mask (a length field narrower than the byte: the CAN DLC), with
    OUT_K_SEL1 the constant K2 / K3 directly; every limit load also clears
    count3.
    - CFG3[13:12] = k: the sampler's timer action presets count1 to
    PRELOAD >> k instead of loading it, so with count-up and wrap-at-preload
    the terminal count is a periodic bit clock whose tick an edge places
    1 - 2^-k of a bit later (k = 2: a sample point 75 % into the bit).
    - CFG3[14] bit-stu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
2026-09-28 local_build from can_ko40: the CAN node tile, the next submission candidate
    src/config.json: MOUTH_KEEPOUT_WIDTH 40. With the CAN datapath additions
    the same netlist placed with +13.9 % inflation at 60 um (runs/can, stopped
    in global routing) and with +3.9 % at 40 um; one draw each.
    runs/can_ko40 = this tree's full flow from synthesis, signed off clean:
    route DRC 0, antenna 0, KLayout DRC 0, LVS 0 (nothing unmatched), IR
    drop 0.56 mV, no hold violations. GPL congestion 1.329, GRT overflow
    16187, post-GRT repair 65 min (154 buffers, 284 upsizes, +0.3 % area,
    its slow-corner estimate -0.14 ns over 3 endpoints); detailed routing to
    0 at pass 16, antenna rounds of 33 and 2 diodes, clean at pa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
    [metrics.csv]
2026-09-29 UART RX chroma, parked spare muxes (input 31), CAN RX caveat removed
    - chromas/chroma_uart_rx.v: 8N1 receiver (5 states) on the periodic bit
    clock with the sampler's mid-bit preset (k = 1); bytes to the RX FIFO,
    CRC-8 over the data bits (uart_tx's trailer); docs 4b.4
    - chromas/tinyqv32.cfg: `muxes: { unused: 31 }` - the compiler now parks
    every unused input mux on input 31 (no more accidental in_prev capture
    through a spare mux on input 0); all chroma outputs recompiled
    - chroma_can_rx.v / docs 4b.3: the ui_in[0] caveat is gone (RXD stays on
    ui_in[3])
    - tests: models.py UartTx, UartRxTest (nominal, +-5 %, back-to-back,
    framing error, CRC) and UartLoopTest (uart_tx shard 0 -> uart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
    [tinyqv32.cfg]
2026-09-29 Ethernet TX test: every TXD edge must sit on the half-bit grid
    EthDecoder records the clock of every TXD edge while TX_EN is high and
    reports the ones off the half-bit grid of the frame's first edge (a
    state that cost a clock would show as a phase step); EthernetTxTest
    asserts there are none on all three frames. Measured 873 / 3715 / 1063
    edges in the 72 / 312 / 92 byte frames, all on the 3-clock grid, byte
    and phase boundaries and PRELOAD2 ticks included: the transmitter has
    no data-dependent phase steps at 60 MHz.
    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
2026-09-29 JTAG master chroma: TAP walks and IR / DR scans from the FIFOs
    chromas/chroma_jtag_master.v (14 states, unfractured): TCK on
    uo_out[1], TMS on uo_out[2], TDI on uo_out[3], TDO on ui_in[2]. One
    operation is N bits (LIMIT3 = N - 1, 1 .. 256) shifted LSB first from
    FIFO B with the TDO bits back in FIFO A, started by a toggle of
    host_in[0], host interrupt at the end:
    - host_in[1] = 1: walk, the bytes are a TMS pattern
    - host_in[1] = 0: scan, the bytes are TDI and TMS rises on the last bit
    (Shift -> Exit1); COMPARE != 0 keeps TMS low so the next operation
    continues the same register (scans longer than 256 bits)
    TDI and TMS change when TCK falls, TDO is taken at the end of TCK high:
    half pe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
2026-09-29 SpaceWire: transmitter and receiver chromas, Data-Strobe clock for the sampler
    RTL (prism_periph.v): the sampler's edge code 3 (unused until now) makes
    its clock the selected input xor the next of inputs 0-7, either edge:
    the bit clock of a Data-Strobe pair. An 8:1 mux and an xor per shard.
    Lint unchanged (94 kinds); the 37 unit tests pass.
    chroma_spw_tx.v (13 states, one shard): D / S on uo_out[1] / [2], every
    bit exactly one period of the bit clock (5 clocks or more; 6 = 10 Mb/s at
    60 MHz), the next character chosen inside the last bit of the current
    one. NULLs while idle, FCT and EOP / EEP on host toggles, data from the
    FIFO under credit: count2 = FCTs left, count3 = characters used of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
2026-09-30 SpaceWire link, the passive end: the chromas start, run and restart it themselves
    RTL (prism_periph.v): fractured, inputs 26 and 27 are the other shard's
    pin_out[1] and pin_out[2], registered (low while the PRISM is disabled,
    held while that shard is halted): two levels an FSM holds up for its
    neighbour, where the semaphore is an event. Unfractured they stay FIFO
    B's flags.
    chroma_spw_rx.v (15 states): QUIET waits for the line to be silent for
    the time-out, FIRST for the first bit of a NULL, parity and flags from
    zero; from then on pin_out[1] is up. Every error (parity, escape, a
    time-code, disconnect) interrupts, adds one to count3 and goes back to
    QUIET. count1 counts up and is cleared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
    [chroma_spw_fct_stub.c, chroma_spw_fct_stub.py, chroma_spw_fct_stub.v, chroma_spw_rx.c, chroma_spw_rx.py, chroma_spw_rx.v, chroma_spw_tx.c, chroma_spw_tx.py]
2026-09-30 SWD host chroma: requests, turnarounds, the ACK, reads and writes
    chromas/chroma_swd_host.v (20 states, unfractured): SWCLK on uo_out[1],
    SWDIO out on uo_out[2] with its output enable on uo_out[3] for an
    external buffer, the line's level on ui_in[2]. A raw operation sends
    LIMIT3 + 1 bits from FIFO B (line reset, JTAG-to-SWD, idle clocks); a
    transfer sends the request byte, releases the line for the turnaround,
    takes the 3-bit ACK and then, on OK, 33 bits of data in for a read or
    33 bits out after another turnaround for a write. FIFO A gets the ACK
    (>> 5) and the data read with its parity; the host makes and checks the
    parities. Bit counts are count3 with its limit loaded from K2 (2) and
    K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
    [chroma_swd_host.c, chroma_swd_host.py, chroma_swd_host.v, models.py, prism_tests.py, test.py]
2026-09-30 PS/2 host chroma: a keyboard or mouse port, both directions, one shard
    chromas/chroma_ps2_host.v (16 states): CLK and DATA pull-low on
    uo_out[1] and [2] through open-collector buffers, the levels on
    ui_in[2] and [3]. From the device the sampler is clocked by CLK's
    falling edges; start, eight bits, odd parity (the CRC unit as a parity
    accumulator) and stop, the byte to the FIFO with the interrupt, an
    error otherwise (interrupt, count3 + 1). To the device on a host
    toggle: CLK held low for the time-out period, DATA low, CLK released,
    the byte from K0 and its parity from K1 on the device's clock, the
    acknowledge checked. count1 is the hold time and the frame time-out,
    timer 2 the wait for th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
    [chroma_ps2_host.c, chroma_ps2_host.py, chroma_ps2_host.v, models.py, prism_tests.py, test.py]
2026-09-30 local_build from spw: the SpaceWire link tile, the next submission candidate
    runs/spw = this tree's full flow from synthesis (count3 b5054ac's RTL:
    the sampler's Data-Strobe clock and the cross-shard status inputs; the
    SWD and PS/2 chromas need no RTL), the can_ko40 recipe, signed off
    clean: route DRC 0, antenna 0, KLayout DRC 0, LVS 0 (nothing
    unmatched), IR drop 0.46 mV, no hold violations. GPL congestion 1.285
    with no inflation, GRT overflow 12776, post-GRT repair 51 min (186
    buffers, 372 upsizes, slow-corner estimate -0.245 ns over 2 endpoints);
    detailed routing to 0 at pass 53 after a stall of nineteen passes at two
    Metal2 spacing violations between a signal and the clock tree's root,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
    [metrics.csv]
2026-09-30 local_build from spw_fix: the spw tile with one Metal2 jog rewritten (M2.b)
    The Tiny Tapeout precheck on 541a323 failed its KLayout SG13CMOS5L DRC
    with one M2.b (Metal2 space or notch 0.21 um) at (1008.855,17.095)-
    (1009.06,17.14): the detailed router had drawn net393's Metal2 with two
    jogs of 0.05 and 0.055 um around a Via1 near the tile's bottom edge, and
    the merged shape's reflex corners sat 0.2099 um apart. The local flow
    never saw it because the pinned PDK snapshot's KLayout deck runs almost
    no rules (tools/drc_deck.py explains; the CLI launches of the recent
    candidates did not add its override), while the precheck runs the full
    deck at the same PDK commit.
    runs/spw_fix = runs/spw con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
    [metrics.csv]
2026-09-30 GitHub Pages: a landing page with the 3D viewer and the SRAM macro write-up
    The Pages site was the TT viewer action's index.html, which only redirects
    to the 3D GDS viewer. The viewer job now runs the action's steps itself
    (download the tt_submission and gds_render artifacts, copy the GDS, OASIS
    and render into gh-pages, upload, deploy) and takes the pages from site/:
    site/index.html landing page: a card for the 3D viewer (the link
    is built from the page's own URL, as the action's
    redirect was) and one for the write-up, the 2D
    render, links to the source, the TT Explorer and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
2026-09-30 VGA on PRISM: uo_out[0] in the pinmux, six comm lanes, the vga_px / vga_ln chromas
    A 160x120 RGB222 frame buffer on the Tiny VGA PMOD (R1 G1 B1 VSync R0 G0
    B0 HSync on uo_out[0..7]) at 640x480 timing with a 3-clock pixel: every
    pixel byte popped from FIFO B into comm and held four pixels. Two RTL
    changes in prism_periph.v (section 4b.11):
    - uo_out[0] joins the pinmux: PINMUX[23:21] names its source with the
    usual codes, pin_src / pin_claim / latched_out are eight wide, the
    hardwired 0 is gone. A chroma's 21-bit pinmux_reg leaves the field at
    pin_out[0] / shard 0, which TinyQV's GPIO output function select (UART
    TX by default) keeps invisible, so nothing existing changes.
    - the mul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
2026-10-01 VGA line replay: the SRAM FIFO re-pushes on pop, one TX DMA copy per source line
    Each 160-byte source line is shown four times from one fetch. FIFO B
    holds exactly the line; on three showings out of four every pop pushes the
    popped byte back in at the tail (prism_sram_fifo.v `repush`: push_ok
    includes the recirculation, the push byte is the head, the count stays),
    so the line circulates in order; the fourth showing consumes it, and as it
    begins the line shard interrupts TinyQV, which copies the next line behind
    it with the TX DMA. Section 4b.12.
    - prism_periph.v: CFG3[29] FIFO_REPUSH makes cond_out[0] the re-push
    strobe (exec-gated, SRAM FIFO only); txd_hold tells the TX DMA that
    the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
2026-10-01 Anchor steps: pin the registers to a good earlier draw before global placement
    Project.AnchorSequential (right before global placement, after the rows
    are cut, the taps and the PDN are in) sets every flop and latch FIRM at
    the spot a reference run had it, matched by the RTL name of the net on
    its data output (instance names are renumbered every synthesis); the
    table comes from tools/seq_placement.py on that run's placed ODB
    (tools/placements/can_ko40_placed_seq.json). Project.ReleaseAnchors sets
    them back to PLACED right after global placement: FIRM only has to steer
    the global placer, and left on it breaks the resizers' in-place upsizing
    (a nor2_1 swapped for a nor2_2 on the spot overlaps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
    [librelane_plugin_prism_pdn.py, odb_anchor_cells.py, odb_anchor_release.py, odb_anchor_seq.py]
2026-10-01 local_build from vga3_anchor: the VGA tile, the next submission candidate
    The replay tree (2dd925f: uo_out[0] in the pinmux, six comm lanes, the
    SRAM FIFO re-push, the TX DMA block field, the vga_px / vga_ln chromas)
    hardened at density 57 / keep-out 40 with the registers anchored to
    can_ko40's placement (Project.AnchorSequential, released after global
    placement). DRT 0 at pass 45 plus two antenna re-routes, KLayout 0 on
    the full ihp-open-pdk-dev deck, LVS 0, antenna 0; typ setup +0.261 ns,
    hold +0.216 ns, slow -5.30 ns (as before); 72645 instances. Free draws
    of the same netlist failed timing by 1.8 ns on the host read path or
    stalled in detailed routing. gds/info.yaml refreshed to the r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
    [metrics.csv]
2026-10-01 HDLC: a synchronous receiver and transmitter chroma, no RTL change
    chroma_hdlc_rx (10 states; RXC ui_in[2], RXD ui_in[3]) follows the clock
    itself, counts the ones in count2 (COMPARE 5), drops the stuff bit after
    five ones, tells a flag from an abort on the sixth, shifts data in
    through cond_out[0] with the CRC-16 / X.25 and pushes whole bytes into
    the FIFO; a frame ends at a flag with FLAGS F0 = FCS good and an
    interrupt. Bits are committed as they arrive, so a good frame's CRC
    ends at the X.25 residue run through the flag's first six bits: 0x9F0B
    (CRC_EXPECTED). chroma_hdlc_tx (11 states; TXC uo_out[3], TXD uo_out[2])
    runs a free half-bit tick, idles with flags, and on a host_in[0] toggl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
2026-10-01 Chip art: Calvin in Metal4 in the lower-right corner
    tools/chip_art.py turns a bitmap into a Metal4-only GDS cell on a 0.6 um
    pixel grid: the avatar's light disc becomes a metal plate and the ink
    strokes slots in it, every width and gap a multiple of 0.6 um so the
    Metal4 rules (width 0.20, space 0.21, wide-metal 0.24 and 0.6) hold by
    construction, corner-only contacts removed, exclusions grown by a
    clearance, a nofill marker over the box, and the merged shapes re-checked
    before the cell is written. --extent lets the picture be larger than
    the drawn --box: the 47 um disc sits in the 36 um channel between PDN
    pairs 9 and 10 at the bottom of the tile (x 1634.9-1670.9, y 4.4-51.8),
    where the fl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
    [librelane_plugin_prism_pdn.py]
2026-10-01 local_build from art: the VGA tile with the Calvin art, the next submission candidate
    Same RTL as 1f4de45 (2dd925f plus formatting), registers anchored to
    vga3_anchor's placement, the Metal4 art in the lower-right corner with
    its keep-out. DRT 0 at pass 53 plus one antenna round (60 diodes),
    KLayout 0 on the full ihp-open-pdk-dev deck with the art in place, LVS 0,
    antenna 0; typ setup +0.322 ns, hold +0.226 ns, slow -6.12 ns; 72586
    instances. gds/info.yaml refreshed.
    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
    [metrics.csv]
2026-10-02 Chip art as rectangles: the 3D viewer throws on a polygon with holes
    The merged face plate has holes (the eyes), which GDS and OASIS can only
    write as one boundary with cut lines that visits the same vertices
    twice; Tiny Tapeout's gds-viewer triangulates with CDT, which throws on
    that (an uncaught exception in the gds_processor wasm, nothing drawn).
    Bisected with files served to the viewer from a local CORS server: the
    spw_fix and vga3_anchor tiles load, the cut-line art fails alone and in
    the tile, the art as rectangles loads. tools/chip_art.py now writes one
    rectangle per horizontal run of pixels (392 for Calvin) and never a
    merged polygon; the DRC merges touching shapes before it checks,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
2026-10-02 local_build from art: the art as rectangles, same sign-off
    The flow re-run from Project.ChipArt on the signed-off routing of
    runs/art: only the three GDS views and the LEF change. KLayout 0 on the
    full deck, LVS 0, antenna 0, typ +0.322 / hold +0.226 as before.
    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
    [metrics.csv]
2026-10-02 Chip art on bare oxide: cut the rows under the picture, keep every layer out
    Project.ArtKeepout ("+OpenROAD.CutRows", CHIP_ART_CUT_ROWS) splits the
    standard-cell rows under the art's box into left and right segments
    before the PDN is made (odb_art_keepout.py), so nothing is ever placed
    there, filler and decap included, and no Metal1 rails are drawn there
    since the rails follow the rows. ROUTING_OBSTRUCTIONS on Metal2, Metal3
    and Metal4 keep the router out, and chip_art.py --nofill all puts the
    fill-exclusion marker of every layer (Activ, GatPoly, Metal1-Metal4) over
    the box for the chip-level fill. The picture moves to the channel
    between the second-row and top-row CFGMEMs (x 1634.9-1670.9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
2026-10-02 local_build from art_up: Calvin on bare oxide, the next submission candidate
    Same RTL as 1f4de45, registers anchored to vga3_anchor's placement, the
    rows cut and all layers kept out under the picture. DRT 0 at pass 57
    plus two antenna rounds, KLayout 0 on the full ihp-open-pdk-dev deck with
    the art in place, LVS 0, antenna 0; typ setup +0.360 ns, hold +0.223 ns,
    slow -7.69 ns; 72371 instances.
    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
    [metrics.csv]
